Jthiss/R_DeviceControlHub/1.Hardware/Test/Power_Test/image/photo2pixel_download (2).png

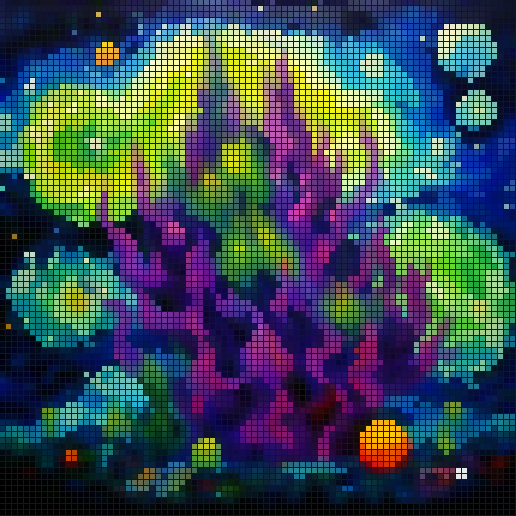
1.Hardware/Test/Power_Test/image/photo2pixel_download (2).png
