Jthiss/R_DeviceControlHub/1.Hardware/Dev/3D/README.assets/image-20240807125515084.png

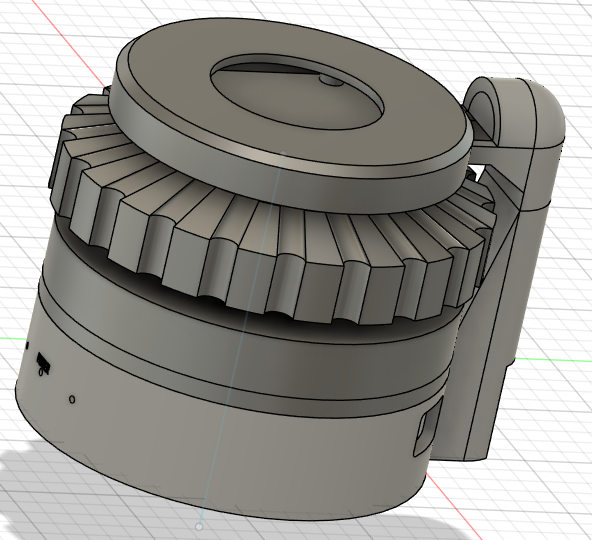
1.Hardware/Dev/3D/README.assets/image-20240807125515084.png
