Jthiss/R_DeviceControlHub/README.md

# R_DeviceControlHub
通过WiFi、FOC、CAN/RS485、LCD实现的智能设备控制按钮（个人兴趣项目）

----

### 1.说明

##### 关于项目起因：

这个项目是因为最近卧室屏幕的显示器挂灯旋钮越来越不灵敏，而且经常需要在两个地点使用，一个旋钮拿来拿去有点麻烦。不过主要还是个人想要实现旋钮的功能拓展（用旋钮控制PC系统音量然后后续可以嵌入键盘中做更多有意思的），但目前个人能力和工作之余时间有限，所以通过先实现当下需求的功能再考虑下一步。
