Jthiss/R_DeviceControlHub/3.Docs/ESP32/note.md

[Quick reference for the ESP32 — MicroPython latest documentation (86x.net)](http://micropython.86x.net/en/latet/esp32/quickref.html)
