Jthiss/R_DeviceControlHub/1.Hardware/README.md

## 记录

+ `2024-7-14`硬件功能基本上测试完毕，可以开始考虑画板和外壳设计了

# 说明

+ `./Test `用来测试部分硬件功能（模块形式）
+ `./Dev`工程
