Jthiss/R_DeviceControlHub/2.Firmware/README.md

## 说明

+ `./Test`是包含前期的一些不同平台下的测试工程和产品相关的参考代码，也是demo（检查部分简易功能时使用）
+ `./Dev`放的是可以实现项目目标效果的的工程
