Jthiss/R_DeviceControlHub/1.Hardware/Dev/3D/README.md

## 说明

第一次搞外壳机械设计，实在是很蹩脚，不过能用就可以了



### 外壳螺母需求

| 规格 | 数量  |
| --- | ----- |
| M2\*2\*3 | 11 |
| M2\*5\*3 | 10 |
| M2.5\*2\*3.5 | 4 |
| ~~M2\*12*3(转为2个6组合)~~  | ~~4~~ |
| M2\*6\*3 | 8 |
| ~~M2\*10\*3(转为2个5组合)~~ | ~~3~~ |

### 外壳螺丝需求

| 规格 | 数量 |
| --- | ---- |
| M2\*8 | 4 |
| M2\*9 | 4 |
| M2.5\*4 | 4 |
| M2.5\*5 | 4 |
| M2.5\*6 | 4 |
| M2.5\*7 | 4 |
| M2.5\*8 | 4 |
| M2\*12  | 4 |
| M2\*10  | 3 |
