Jthiss/R_DeviceControlHub/3.Docs/FOC/note.md

..

### 5V升压方案

#### 电池+DCDC

##### XL6019E1
