Jthiss/R_DeviceControlHub/3.Docs/Yeelight/Yeelight开发文档.md

[yeelight package — python-yeelight 0.7.13 documentation](https://yeelight.readthedocs.io/en/latest/yeelight.html#)
