Jthiss/R_DeviceControlHub/3.Docs/Motor/screenshot1.jpg

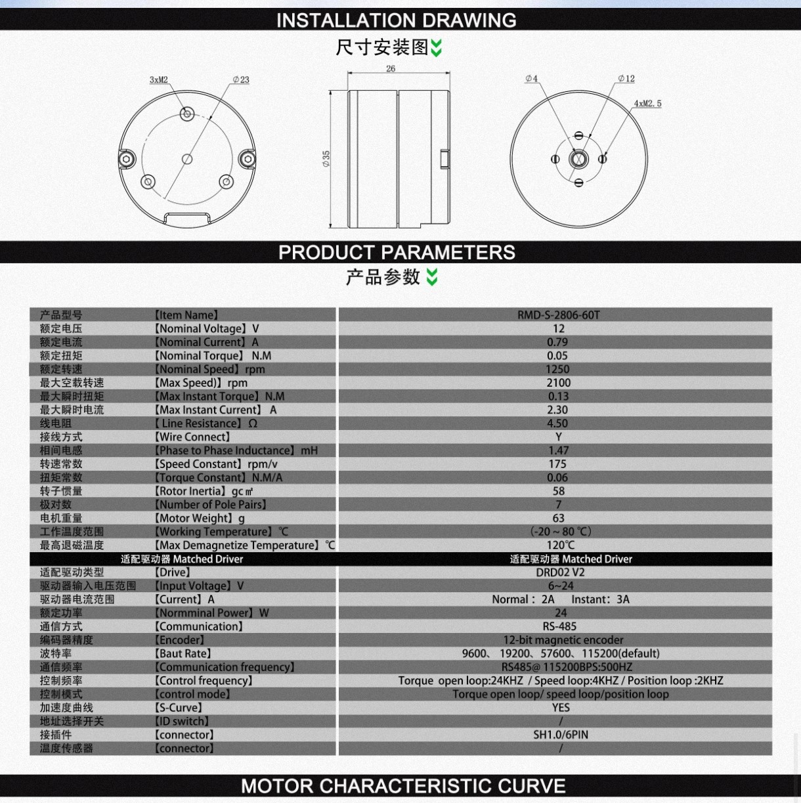
3.Docs/Motor/screenshot1.jpg
