Jthiss/R_DeviceControlHub/3.Docs/R_DCHub框架图.png

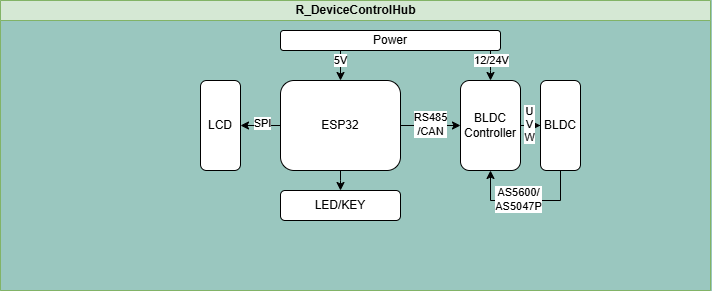
3.Docs/R_DCHub框架图.png
