Jthiss/R_DeviceControlHub/1.Hardware/Dev/PCB/BOM_Board_Main_Board_Main_2024-08-04.xlsx

No. | Quantity | Comment | Designator | Footprint | Value | Manufacturer Part | Manufacturer | Supplier Part | Supplier | Layer | Name | Device
1 | 2 | 贴片侧按键 | BOOT0,RST1 | KEY-SMD_1TS003B |  | 贴片侧按键 |  | C9900026825 | LCSC | T | 贴片侧按键 | 贴片侧按键
2 | 1 | 10uF | C1 | C0402 | 10uF | GRM155R61A106ME44D | muRata(村田) | C77000 | LCSC | T | 10uF | GRM155R61A106ME44D
3 | 1 | 100nF | C2 | C0402 | 100nF | GRM155R71H104KE14D | muRata(村田) | C77020 | LCSC | T | 100nF | GRM155R71H104KE14D
4 | 5 | 100uF | C3,C11,C12,C13,C14 | C1206 | 100uF | GRM31CR61A107MEA8L | muRata(村田) | C883598 | LCSC | B |  | GRM31CR61A107MEA8L
5 | 2 | 100nF | C4,C9 | C0402 | 100nF | GMK105BJ104KV-F | TAIYO YUDEN(太诱) | C187828 | LCSC | T |  | GMK105BJ104KV-F
6 | 2 | 10uF | C5,C8 | C0402 | 10uF | GRJ155R60J106ME11D | muRata(村田) | C469527 | LCSC | T |  | GRJ155R60J106ME11D
7 | 2 | 10uF | C6,C10 | C0402 | 10uF | CC0402MRX5R5BB106 | YAGEO(国巨) | C105884 | LCSC | B |  | CC0402MRX5R5BB106
8 | 4 | 100nF | C7,C21,C23,C24 | C0402 | 100nF | MC0402B104K500N5RH | Sunway(信维通信) | C3152552 | LCSC | B | 100nF | MC0402B104K500N5RH
9 | 2 | 100nF | C15,C16 | C0402 | 100nF | MC0402B104K500N5RH | Sunway(信维通信) | C3152552 | LCSC | T | 100nF | MC0402B104K500N5RH
10 | 2 | 100nF | C17,C19 | C0402 | 100nF | C0402C106M9PAC7867 | KEMET(基美) |  | LCSC | B | 100nF | C0402C106M9PAC7867
11 | 2 | 100uF | C18,C20 | CAP-SMD_L3.5-W2.8-R-RD | 100uF | TC211B107K006A | Sunlord(顺络) | C112094 | LCSC | B | 100uF | TC211B107K006A
12 | 1 | 10uF | C22 | C0402 | 10uF | C0402C106M9PAC7867 | KEMET(基美) | C2167654 | LCSC | B | 10uF | C0402C106M9PAC7867
13 | 1 | 1nF | C25 | C0402 | 1nF | MC0402B104K500N5RH | Sunway(信维通信) |  | LCSC | T | 1nF | MC0402B104K500N5RH
14 | 1 | 100nF | C26 | C0402 | 100nF | MC0402B104K500N5RH | Sunway(信维通信) |  | LCSC | B | 100nF | MC0402B104K500N5RH
15 | 3 | 100NF | C27,C30,C31 | C0402 | 100NF | MC0402B104K500N5RH | Sunway(信维通信) |  | LCSC | T | 100NF | MC0402B104K500N5RH
16 | 1 | 100NF | C28 | C0402 | 100NF | MC0402B104K500N5RH | Sunway(信维通信) |  | LCSC | B | 100NF | MC0402B104K500N5RH
17 | 1 | 2.2NF | C29 | C0402 | 2.2NF | MC0402B104K500N5RH | Sunway(信维通信) |  | LCSC | T | 2.2NF | MC0402B104K500N5RH
18 | 1 | SH1.0-6P | CN1 | CONN-SMD_6P-P1.00-H-M_AFC10-S06QCC-00 |  | SH1.0-6P |  | C9900020064 | LCSC | T | SH1.0-6P | SH1.0-6P
19 | 1 | SS34 | D1 | DO-214AB-SMC |  |  |  |  |  | B | SS34 | SS34
20 | 1 | B5819WS | D2 | SOD-323_L1.8-W1.3-LS2.5-FD |  | B5819WS | BORN伯恩半导体 | C511873 | LCSC | T |  | B5819WS
21 | 1 | 4148 | D3 | D1206 |  |  |  |  |  | T | 4148 | 4148
22 | 2 | SMAJ6.5CA (WK) | DA1,DB1 | SMA |  |  |  |  |  | T | SMAJ6.5CA (WK) | SMAJ6.5CA (WK)
23 | 1 | SMAJ6.5CA (WK) | DAB1 | SMA |  |  |  |  |  | B | SMAJ6.5CA (WK) | SMAJ6.5CA (WK)
24 | 1 | 74hc04 | IC1 | SOP14 |  |  |  |  |  | T | 74hc04 | 74hc04
25 | 1 | SP3485 | IC2 | SOP8 |  |  |  |  |  | T | SP3485 | SP3485
26 | 1 | 热插拔轴座 | KEY1 | 热插拔轴座 |  |  |  |  |  | T |  | 热插拔轴座
27 | 1 | 33uH | L1 | IND-SMD_L11.5-W10.0 | 33uH | MS1040-330M | COILMX(迈翔科技) | C380056 | LCSC | B |  | MS1040-330M
28 | 3 | NCD0805R1 | LED1,LED2,LED3 | LED0805-RD_RED |  | NCD0805R1 | 国星光电 | C84256 | LCSC | T | NCD0805R1 | NCD0805R1
29 | 1 | FFC_0.5_8 | P1 | CONN-SMD_8P-P0.50_FGXJ |  | FFC_0.5_8 |  | C9900003973 | LCSC | T | FFC_0.5_8 | FFC_0.5_8
30 | 1 | MX1.25-WS-2P | P2 | CONN-SMD_2P-P1.25-MX1.25-2P-WT |  | MX1.25-WS-2P |  | C9900004162 | LCSC | T | MX1.25-WS-2P | MX1.25-WS-2P
31 | 1 | EMB12P03V | Q1 | POWERTDFN-8_L3.1-W3.1-P0.65-LS3.3-BL |  | EMB12P03V | EMC(杰力) | C461961 | LCSC | B |  | EMB12P03V
32 | 1 | S8050 J3Y | Q2 | SOT-23-3_L2.9-W1.3-P1.90-LS2.4-BR |  | S8050 J3Y | FOSAN(富信) | C2926165 | LCSC | B |  | S8050 J3Y
33 | 2 | 2N3904(SOT-23) | Q3,Q4 | SOT-23-3_L2.9-W1.3-P1.90-LS2.4-TR |  |  |  |  |  | B | 2N3904(SOT-23) | 2N3904(SOT-23)
34 | 4 | 5.1K | R1,R2,R4,R5 | R0402 | 5.1K |  |  |  |  | T | 5.1K | Res_0402
35 | 1 | 1K | R3 | R0402 | 1K |  |  |  |  | T | 1K | Res_0402
36 | 1 | 24kΩ | R6 | R0402 | 24kΩ | ERJ2RKF2402X | PANASONIC(松下) | C409902 | LCSC | B |  | ERJ2RKF2402X
37 | 8 | 10K | R7,R20,R23,R28,R30,R32,R33,R34 | R0402 | 10K |  |  |  |  | B | 10K | Res_0402
38 | 1 | 2.74kΩ | R8 | R0402 | 2.74kΩ | 0402WGF2741TCE | UNI-ROYAL(厚声) | C33360 | LCSC | B |  | 0402WGF2741TCE
39 | 1 | 1kΩ | R9 | R0402 | 1kΩ | 0402WGF1001TCE | UNI-ROYAL(厚声) | C11702 | LCSC | T |  | 0402WGF1001TCE
40 | 2 | 10K | R10,R11 | R0402 | 10K |  |  |  |  | T | 10K | Res_0402
41 | 1 | 100kΩ | R12 | R0402 | 100kΩ | ERJ2RKF1003X | PANASONIC(松下) | C192169 | LCSC | B |  | ERJ2RKF1003X
42 | 2 | 10kΩ | R13,R14 | R0402 | 10kΩ | RC0402FR-0710KL | YAGEO(国巨) | C60490 | LCSC | B |  | RC0402FR-0710KL
43 | 5 | 4.7K | R15,R17,R24,R27,R29 | R0402 | 4.7K |  |  |  |  | T | 4.7K | Res_0402
44 | 1 | 56K | R16 | R0402 | 56K |  |  |  |  | T | 56K | Res_0402
45 | 1 | 4.7K | R18 | R0402 | 4.7K |  |  |  |  | B | 4.7K | Res_0402
46 | 2 | 120R | R19,R21 | R0402 | 120R |  |  |  |  | T | 120R | Res_0402
47 | 2 | 2.4K | R22,R25 | R0402 | 2.4K |  |  |  |  | T | 2.4K | Res_0402
48 | 2 | 4R7 | R26,R31 | R0402 | 4R7 |  |  |  |  | B | 4R7 | Res_0402
49 | 2 | Res1 | RH1,RH2 | F1812 | 100MA (104L) |  |  |  |  | T | Res1 | Res1
50 | 1 | ESP32-S3-WROOM-1-N16R8 | U1 | WIRELM-SMD_ESP32-S3-WROOM-1 |  | ESP32-S3-WROOM-1-N16R8 | ESPRESSIF(乐鑫) | C2913202 | LCSC | T | ESP32-S3-WROOM-1-N16R8 | ESP32-S3-WROOM-1-N16R8
51 | 1 | TP4056 | U2 | ESOP-8_L4.9-W3.9-P1.27-LS6.0-BL-EP |  | TP4056 | TPOWER(天源) | C382139 | LCSC | T |  | TP4056
52 | 1 | XL6019E1 | U3 | TO-263-5_L10.2-W9.9-P1.70-LS14.4-TL |  | XL6019E1 | XLSEMI(芯龙) | C73018 | LCSC | B |  | XL6019E1
53 | 1 | AMS1117-3.3 | U5 | SOT-89_L4.5-W2.5-P1.50-LS4.2-BR |  | AMS1117-3.3 | UMW(广东友台半导体) | C347256 | LCSC | B | AMS1117-3.3 | AMS1117-3.3_C347256
54 | 1 | CH340C | U6 | SOP-16_L10.0-W3.9-P1.27-LS6.0-BL |  | CH340C | WCH(南京沁恒) | C84681 | LCSC | B | CH340C | CH340C
55 | 1 | INA226AIDGSR | U7 | MSOP-10_L3.0-W3.0-P0.50-LS5.0-BL |  | INA226AIDGSR | TI(德州仪器) | C49851 | LCSC | B | INA226AIDGSR | INA226AIDGSR
56 | 1 | MPU6050 | U8 | QFN-24_L4.0-W4.0-P0.50-BL |  | MPU6050 |  | C9900042518 | LCSC | T | MPU6050 | MPU6050
57 | 1 | 10mΩ | U9 | R2512 | 10mΩ | HoYLR2512-3W-10mR-1% | Milliohm(毫欧) | C5375464 | LCSC | B | 10mΩ | HoYLR2512-3W-10mR-1%
58 | 3 | M2铜柱 | U10,U11,U12 | TH_BD4.0-D2.0 |  | M2铜柱 |  | C9900004684 | LCSC | T | M2铜柱 | M2铜柱
59 | 2 | 918-418K2023S40001 | USBC1,USBC2 | USB-C-SMD_TYPE-C-USB-17 |  | 918-418K2023S40001 | 精拓金 | C167321 | LCSC | T |  | 918-418K2023S40001
60 | 3 | WS2812B-6028 | W1,W2,W3 | WS2812B-6028 |  |  |  |  |  | T | WS2812B-6028 | ws2812b-6028
