Jthiss/R_DeviceControlHub/1.Hardware/Dev/3D/屏幕盖板.step

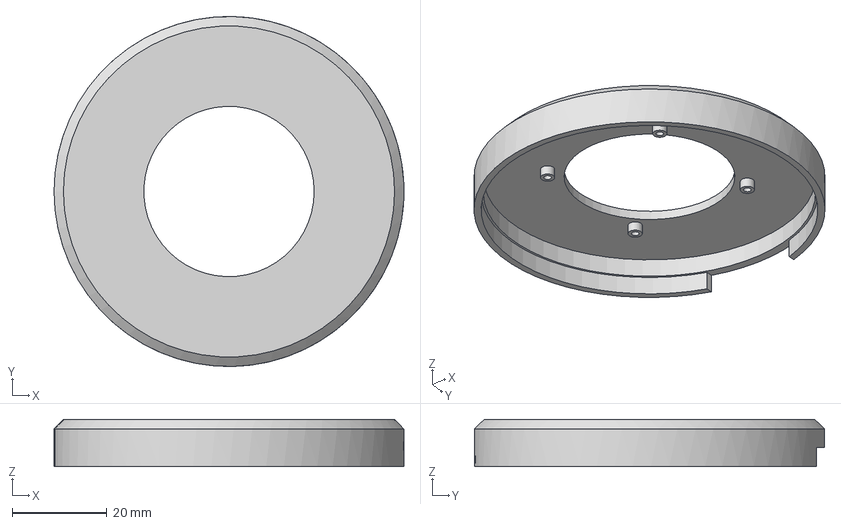
[picture p5: CAD file, 2024-08-07]
1.Hardware/Dev/3D/屏幕盖板.step
74.0 x 74.0 x 10.0 mm
