Jthiss/R_DeviceControlHub/1.Hardware/Dev/3D/底盘连接件.step

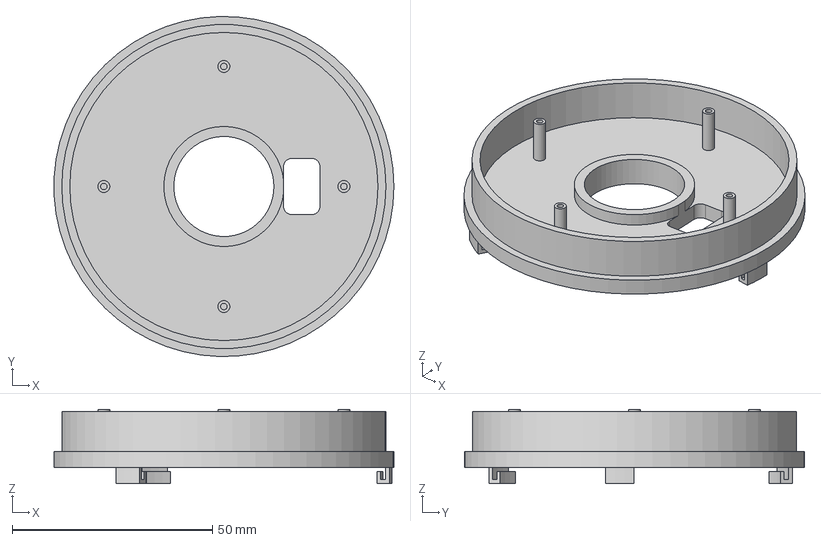
[picture p6: CAD file, 2024-08-07]
1.Hardware/Dev/3D/底盘连接件.step
84.9 x 85.0 x 18.5 mm
