Jthiss/R_DeviceControlHub/1.Hardware/Dev/3D/底盘.step

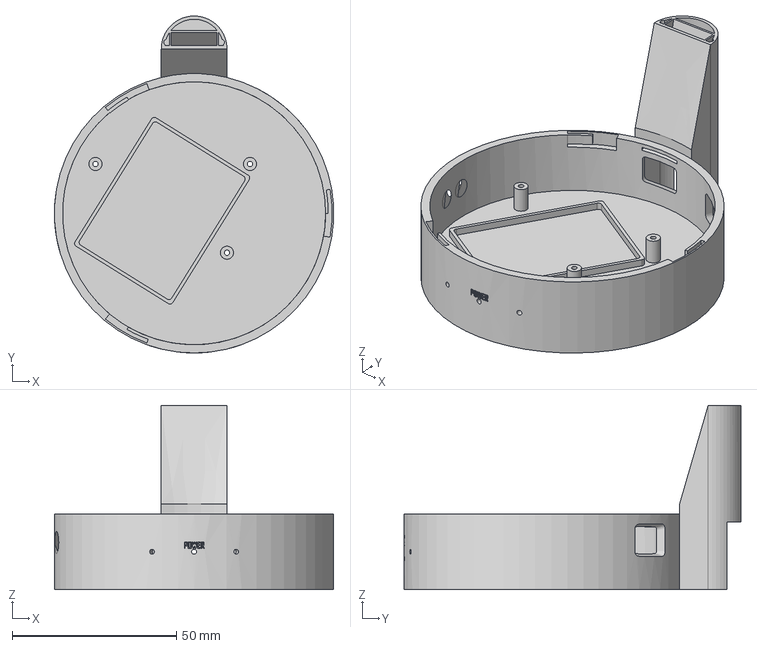
[picture p7: CAD file, 2024-08-07]
1.Hardware/Dev/3D/底盘.step
84.9 x 102.5 x 56.0 mm
