Jthiss/R_DeviceControlHub/1.Hardware/Dev/3D/电机外壳.step

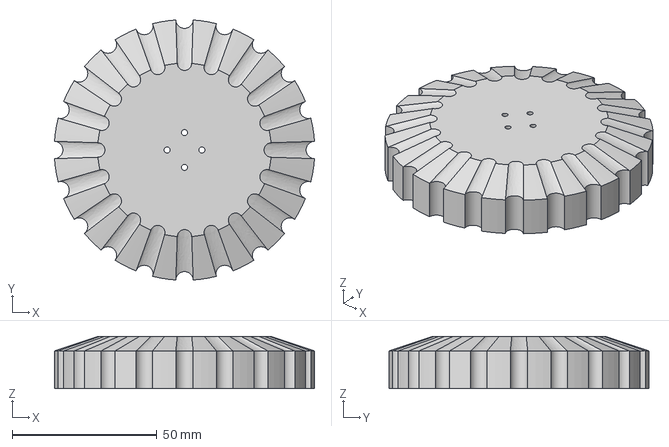
[picture p8: CAD file, 2024-08-07]
1.Hardware/Dev/3D/电机外壳.step
89.8 x 89.8 x 18.0 mm
