Jthiss/R_DeviceControlHub/1.Hardware/Dev/3D/屏幕底板.step

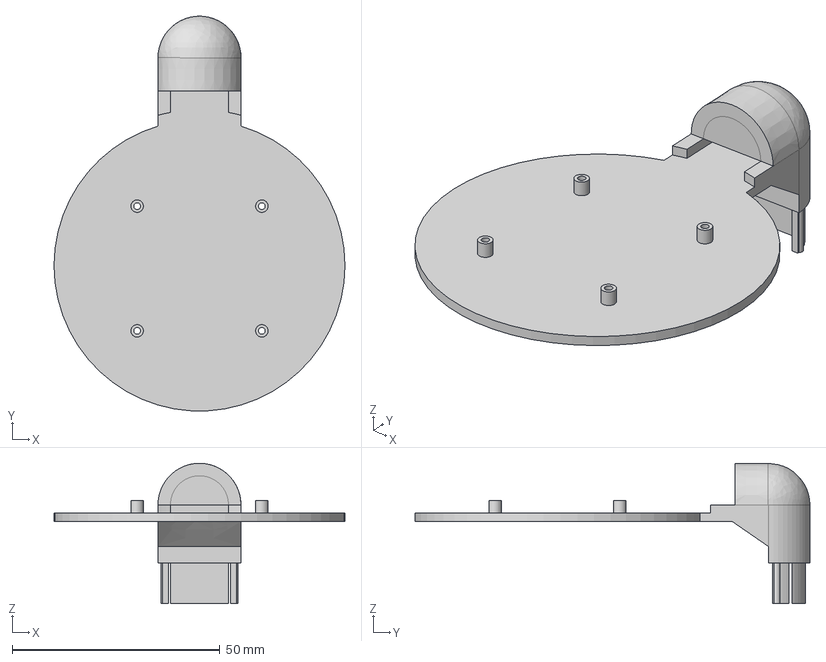
[picture p9: CAD file, 2024-08-07]
1.Hardware/Dev/3D/屏幕底板.step
70.0 x 94.9 x 33.8 mm
