Jthiss/R_DeviceControlHub/1.Hardware/Dev/3D/电机底盘外壳.step

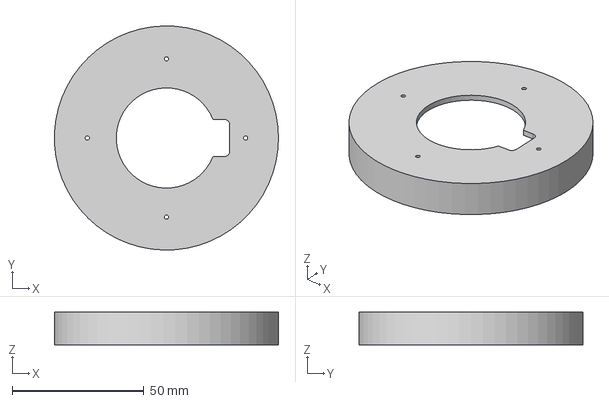
[picture p10: CAD file, 2024-08-07]
1.Hardware/Dev/3D/电机底盘外壳.step
84.9 x 85.0 x 12.5 mm
