Jthiss/R_DeviceControlHub/1.Hardware/Dev/3D/电机底盘.step

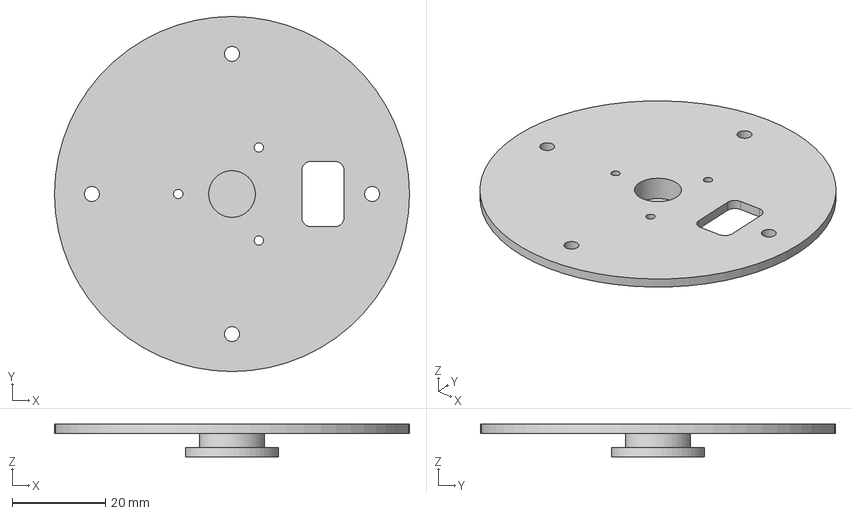
[picture p11: CAD file, 2024-08-07]
1.Hardware/Dev/3D/电机底盘.step
76.0 x 76.0 x 7.00 mm
