Jthiss/R_DeviceControlHub/2.Firmware/Test/README.md

+ LVGL_WiFi---ESP8266测试LCD LVGL WIFI
+ YEE/yeelight-arduino-master---参考的yeelight项目
+ **YEE/ESP32-yeelight-control-master---首选参考的yeelight项目**
+ **LVGL_Yeelight_ESP32--主要测试工程**
+ **RS485_Motor_ESP32**--电机lvgl测试工程（基于ESP32）
+ **RS485_Motor_ESP32S3**--电机lvgl测试工程（基于ESP32S3）
