Jthiss/R_DeviceControlHub/2.Firmware/Test/RS485_Motor_ESP32S3/huge_app.csv

# Name | Type | SubType | Offset | Size | Flags
nvs | data | nvs | 0x9000 | 0x5000
otadata | data | ota | 0xe000 | 0x2000
app0 | app | ota_0 | 0x10000 | 0x300000
spiffs | data | spiffs | 0x310000 | 0xE0000
coredump | data | coredump | 0x3F0000 | 0x10000
