Jthiss/R_DeviceControlHub/1.Hardware/Test/Power_Test/image/photo2pixel_download.png

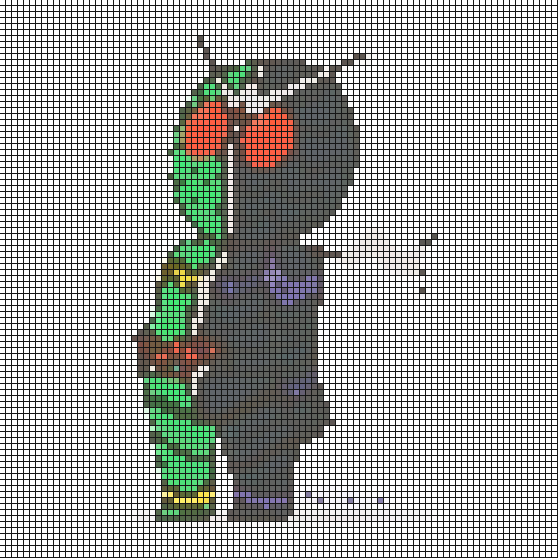
1.Hardware/Test/Power_Test/image/photo2pixel_download.png
