Jthiss/R_DeviceControlHub/1.Hardware/Test/Power_Test/SCH_Schematic1_2024-06-25.pdf

# Power_Inuput

# Battery_charging

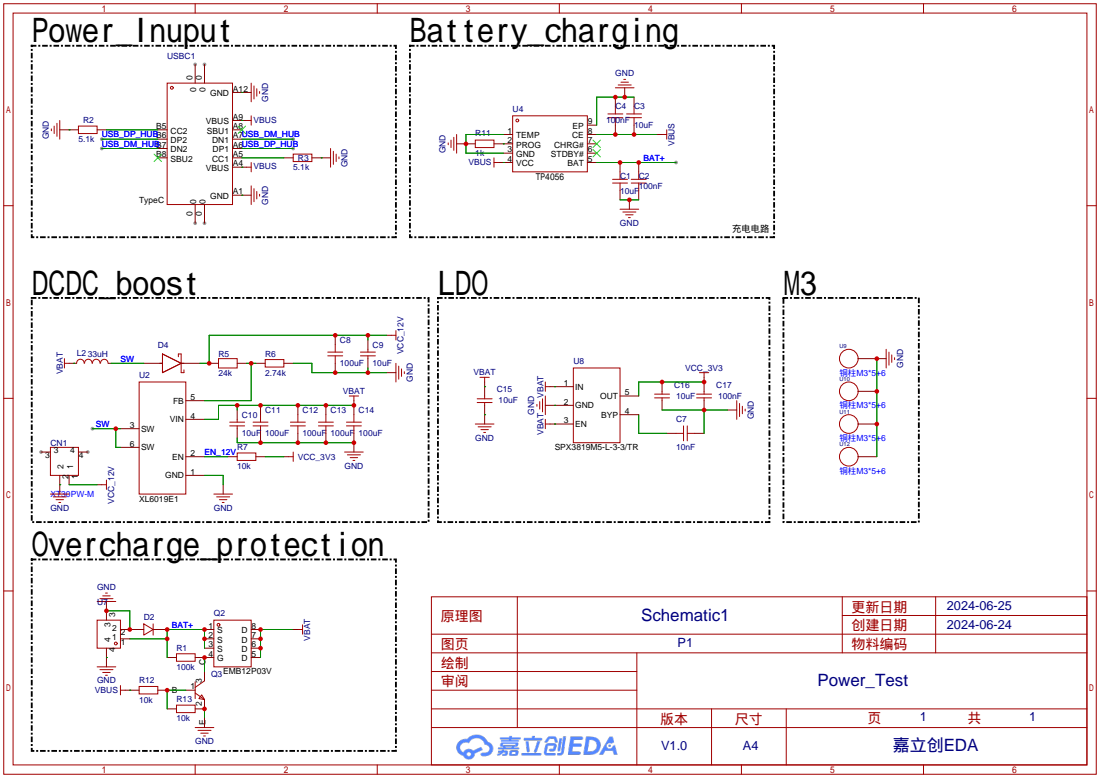
[picture p13: page 1]
