Jthiss/R_DeviceControlHub/1.Hardware/Test/Power_Test/PCB_PCB1_2024-06-25.pdf

U10 | U11

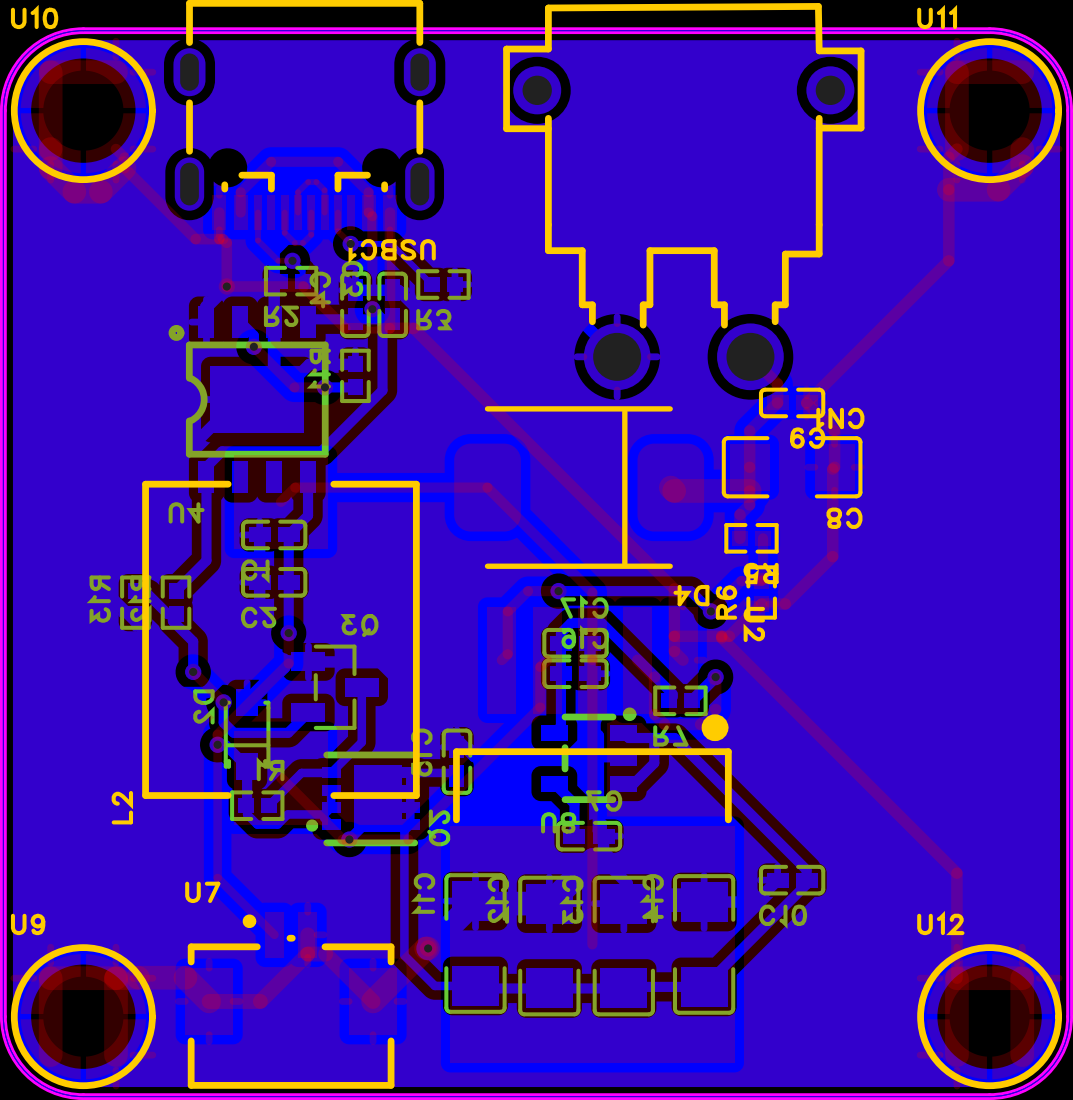
[picture p14: page 1]

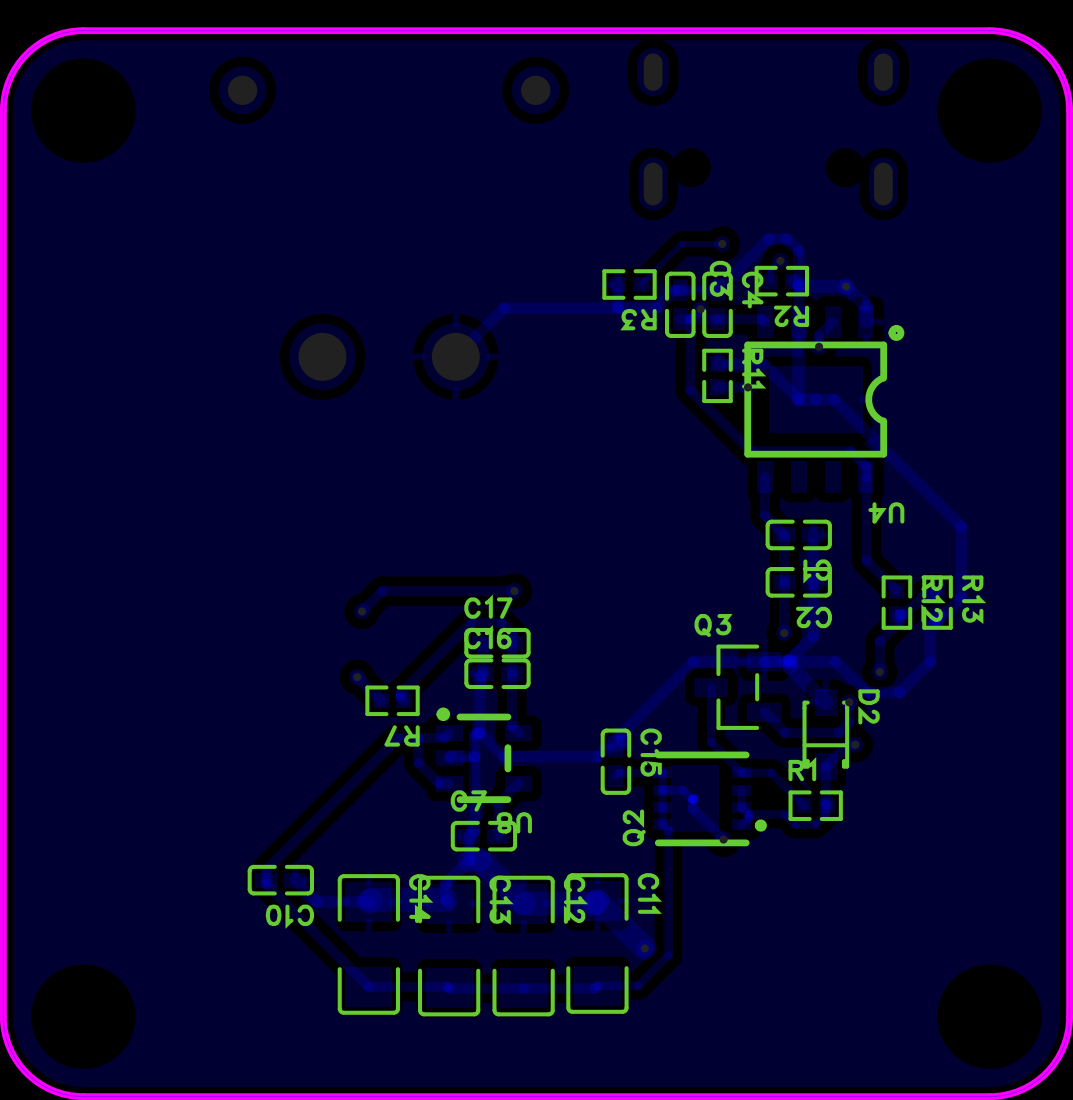
[picture p15: page 2]

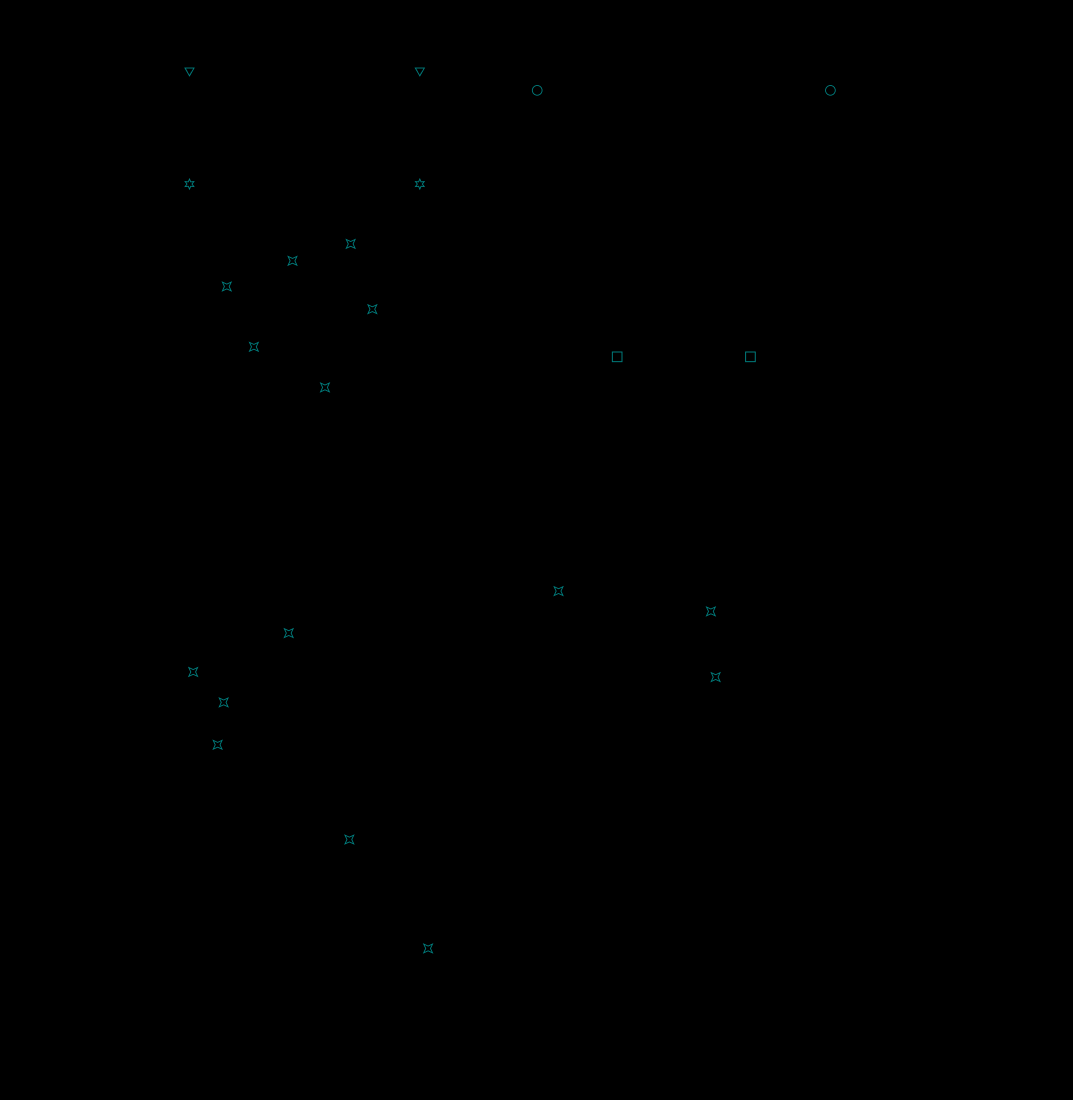
[picture p16: page 3]
