Jthiss/R_DeviceControlHub/(commit log)

2024-06-21 添加项目文件夹
2024-06-21 add some important docs about FOC、Power、LCD
2024-06-24 add temporary esp32 prj 2 set the .pio folder at another sys,after that .pio folder will be deleted
2024-06-24 add temporary esp32 prj-0624
2024-06-25 changed esp32_yeelight testing prj
2024-06-25 add Hardware-Powwer_Test BOM and SCH|PCB
    [BOM_Board1_PCB1_2024-06-25.xlsx]
2024-06-26 find a bug need to fix, will do it after get off work
    [main.cpp, yeelight.cpp]
2024-06-26 fix the bug and add some changes on lvgl test
    [main.cpp, yeelight.cpp]
2024-07-03 添加了电机RS485通讯协议手册
2024-07-03 add some Motor_Control_function
2024-07-04 补全用户motor代码
2024-07-07 添加蓝牙键盘模块，添加旋钮模式代码，实现通过读取电机编码器的多圈角度来控制PC系统音量（待优化）
    [huge_app.csv, partition.csv]
2024-07-11 準備移植到S3上
    [huge_app.csv, partition.csv]
2024-07-14 考虑到lvgl后续扩展flash容量问题，移植了一版到最近拿到的一块ESP32S3上，并加入WS2812作为系统状态灯
2024-07-14 add some folders？
    [BOM_Board1_PCB1_2024-06-25.xlsx]
2024-07-18 changed motor_rs485 uart to Serial1
2024-08-07 把所有涉及功能的基本测试都完成了，并且添加了3D外壳模型
    [BOM_Board_Main_Board_Main_2024-08-04.xlsx, 屏幕底板.step, 屏幕盖板.step, 底盘.step, 底盘连接件.step, 电机外壳.step, 电机底盘.step, 电机底盘外壳.step]
